lisasnt/HSD-RP2040-5-stepper-motor-driver/kicad-project/Huge-Stepper-Driver.kicad_pcb

## KiCad design kicad-project/Huge-Stepper-Driver.kicad_pcb (2022-05-21)

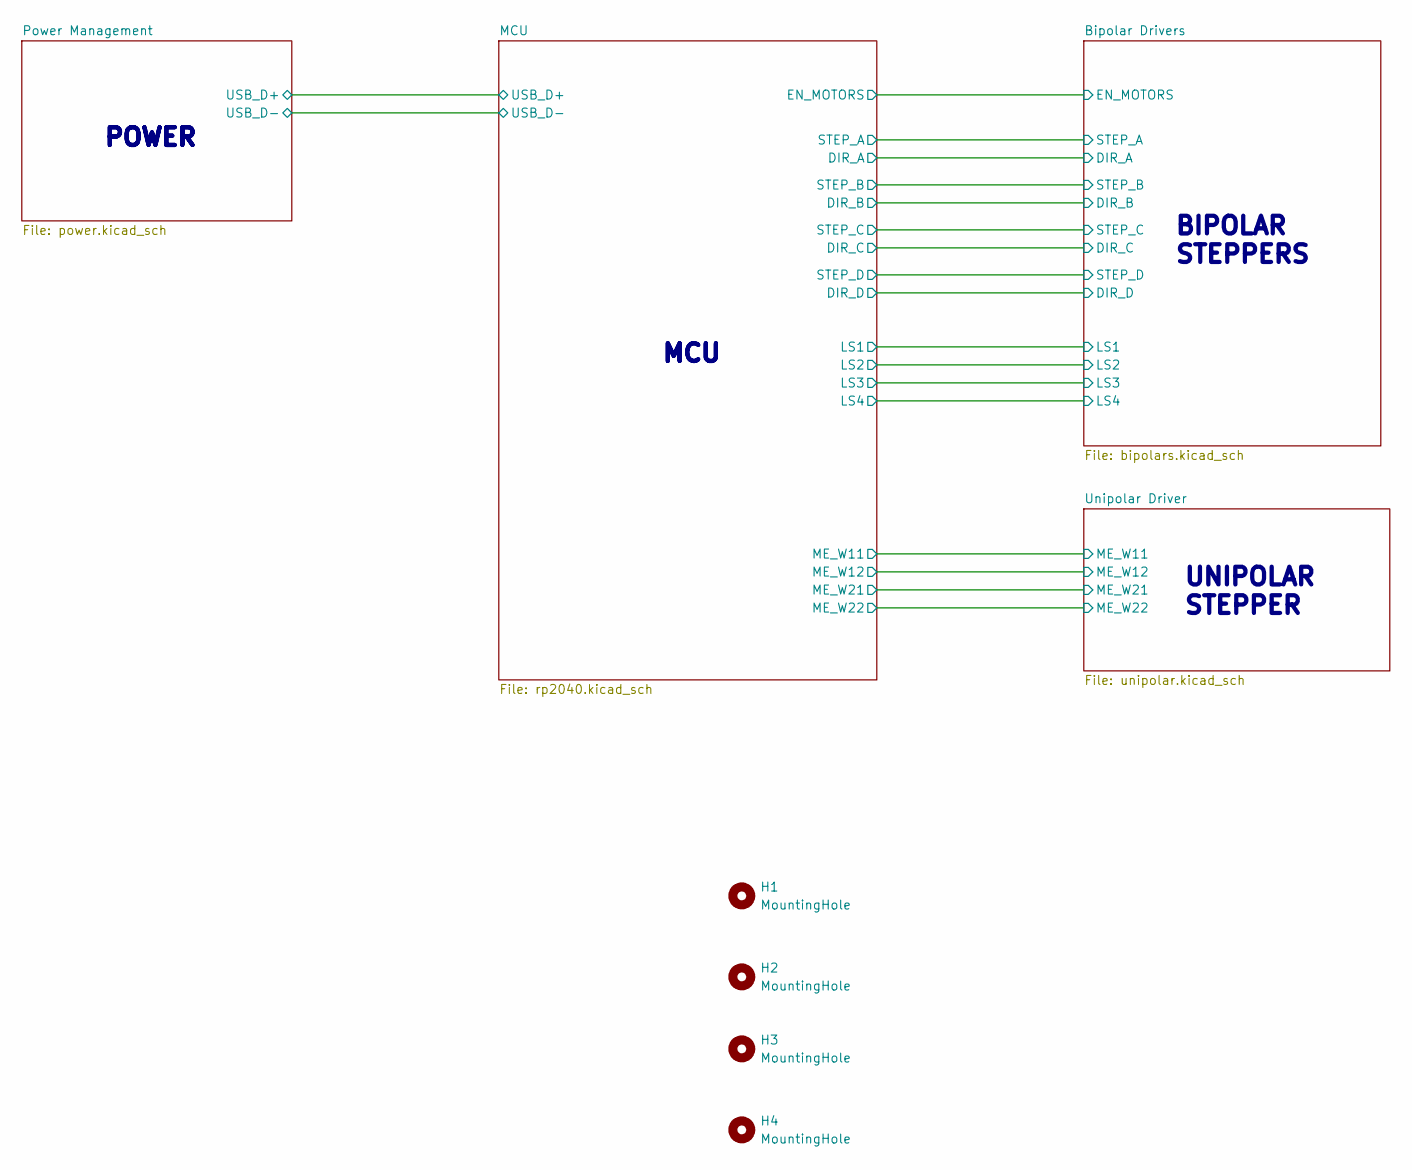
[picture p1: schematic Huge-Stepper-Driver.kicad_sch]

Parts:
H1, H2, H3, H4: MountingHole; MountingHole_3.2mm_M3

Notes on the sheet:
MCU
UNIPOLAR STEPPER
POWER
BIPOLAR STEPPERS

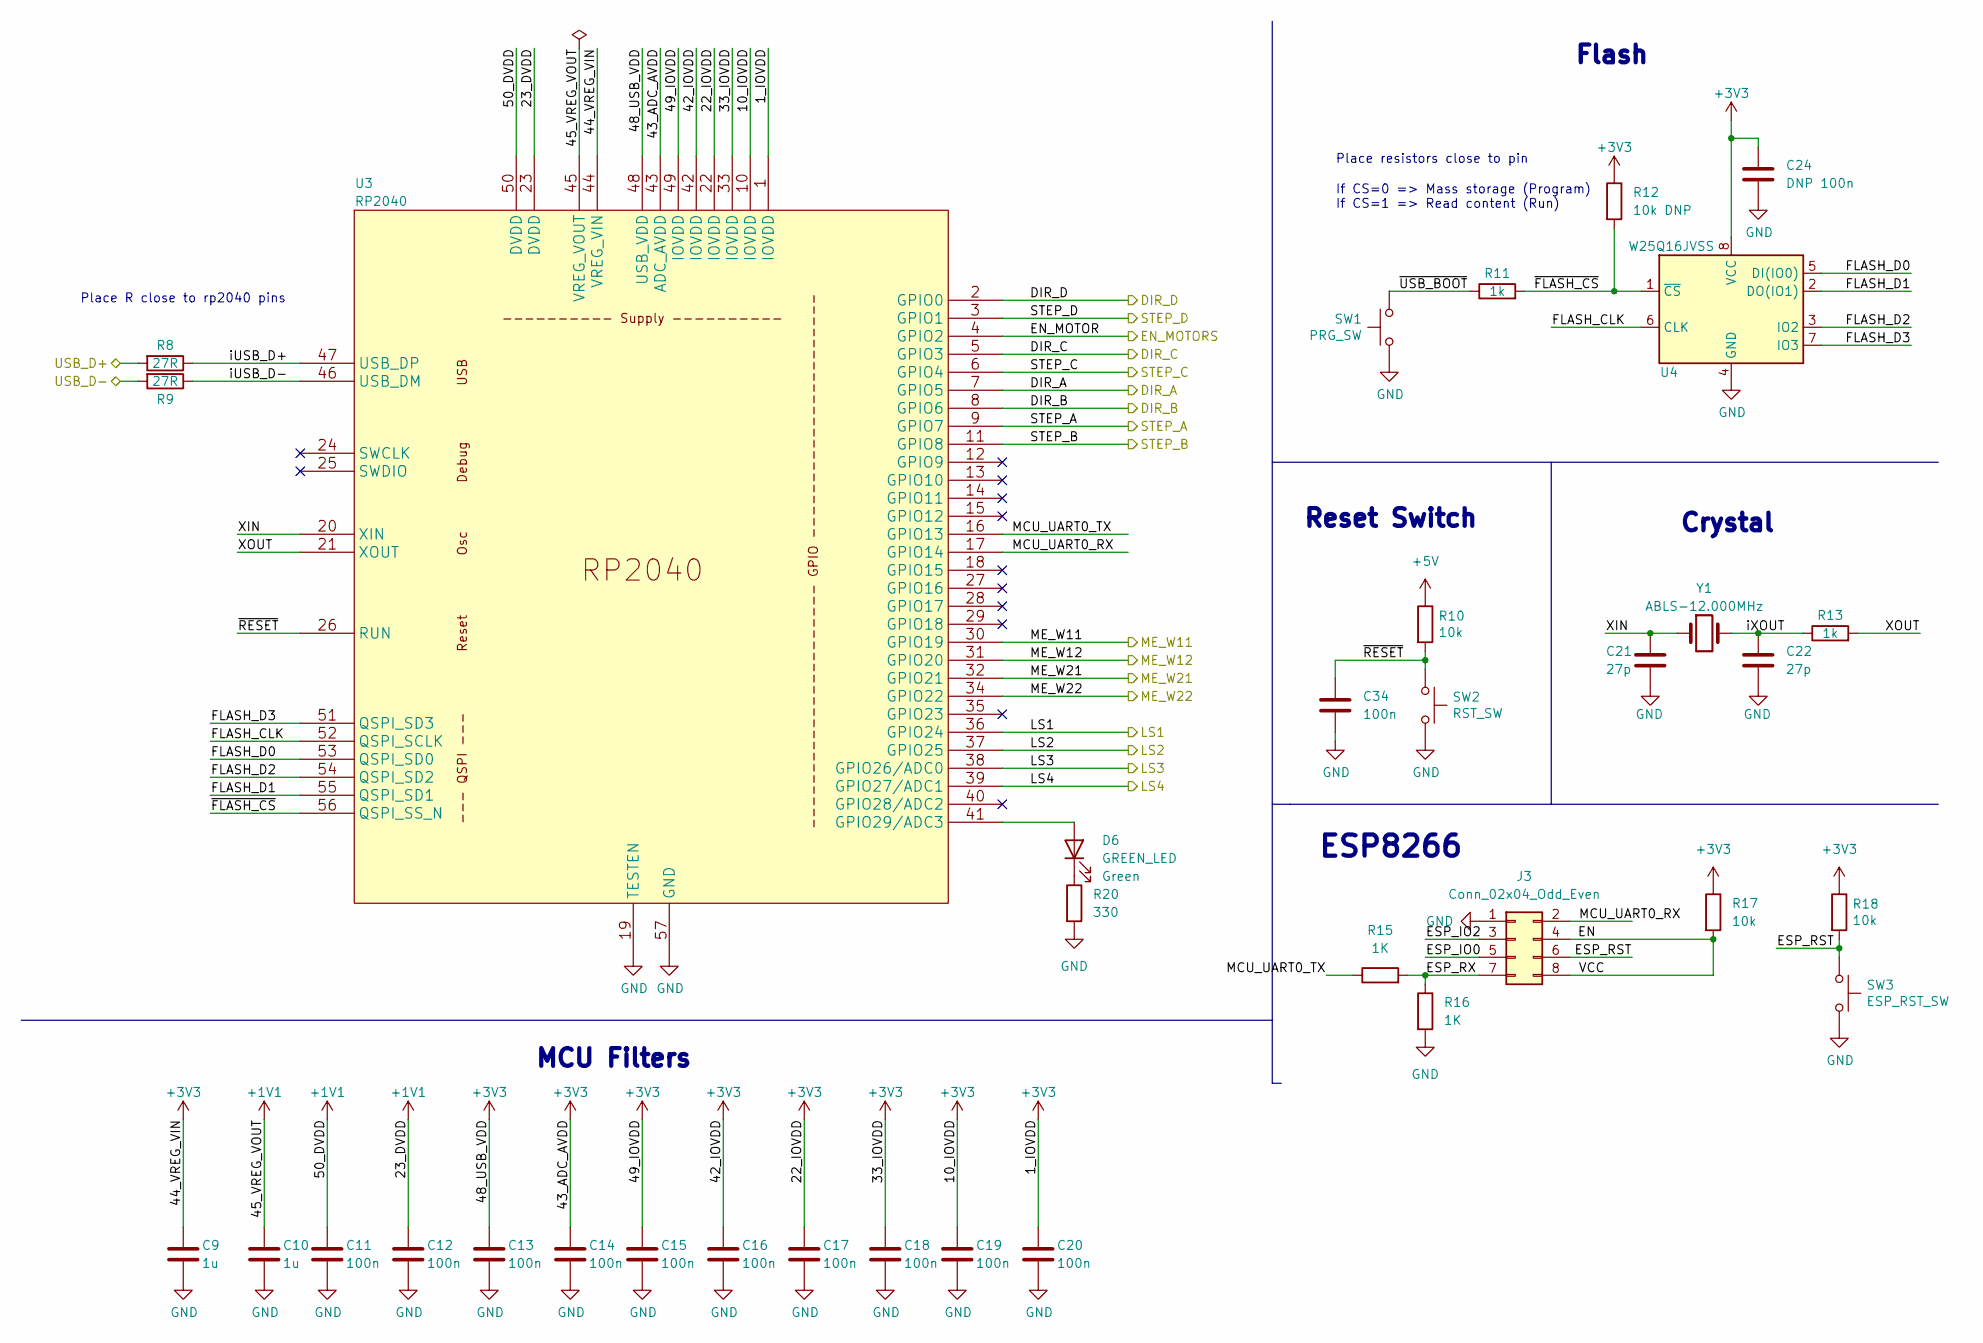
[picture p2: schematic rp2040.kicad_sch]

Parts:
C9, C10: 1u; C_0805_2012Metric
C11, C12, C13, C14, C15, C16, C17, C18, C19, C20, C34: 100n; C_0603_1608Metric
C21, C22: 27p; C_0603_1608Metric
C24: DNP 100n; C_0603_1608Metric
D6: GREEN_LED; LED_0603_1608Metric
J3: Conn_02x04_Odd_Even; PinHeader_2x04_P2.54mm_Vertical
R8, R9: 27R; R_0603_1608Metric
R10, R17, R18: 10k; R_0603_1608Metric
R11, R13: 1k; R_0603_1608Metric
R12: 10k DNP; R_0603_1608Metric
R15, R16: 1K; R_0603_1608Metric
R20: 330; R_0603_1608Metric
SW1: PRG_SW; SW_Push_1P1T_NO_CK_KMR2
SW2: RST_SW; SW_Push_1P1T_NO_CK_KMR2
SW3: ESP_RST_SW; SW_Push_1P1T_NO_CK_KMR2
U3: RP2040; RP2040-Hand-Solder
U4: W25Q16JVSS; SOIC-8_5.23x5.23mm_P1.27mm
Y1: ABLS-12.000MHz; Crystal_SMD_HC49-SD

Connections:
+1V1: C10.1, C11.1, C12.1, U3.23 (DVDD), U3.45 (VREG_VOUT), U3.50 (DVDD)
+5V: R10.1; also elsewhere on the board
/Bipolar Drivers/LS1: U3.36 (GPIO24); also elsewhere on the board
/Bipolar Drivers/LS2: U3.37 (GPIO25); also elsewhere on the board
/Bipolar Drivers/LS3: U3.38 (GPIO26/ADC0); also elsewhere on the board
/Bipolar Drivers/LS4: U3.39 (GPIO27/ADC1); also elsewhere on the board
/MCU/DIR_A: U3.7 (GPIO5); also elsewhere on the board
/MCU/DIR_B: U3.8 (GPIO6); also elsewhere on the board
/MCU/DIR_C: U3.5 (GPIO3); also elsewhere on the board
/MCU/DIR_D: U3.2 (GPIO0); also elsewhere on the board
/MCU/EN: J3.4, J3.8, R17.2
/MCU/EN_MOTOR: U3.4 (GPIO2); also elsewhere on the board
/MCU/ESP_IO0: J3.5
/MCU/ESP_IO2: J3.3
/MCU/ESP_RST: J3.6, R18.2, SW3.1
/MCU/ESP_RX: J3.7, R15.2, R16.1
/MCU/FLASH_CLK: U3.52 (QSPI_SCLK), U4.6 (CLK)
/MCU/FLASH_D0: U3.53 (QSPI_SD0), U4.5 (DI(IO0))
/MCU/FLASH_D1: U3.55 (QSPI_SD1), U4.2 (DO(IO1))
/MCU/FLASH_D2: U3.54 (QSPI_SD2), U4.3 (IO2)
/MCU/FLASH_D3: U3.51 (QSPI_SD3), U4.7 (IO3)
/MCU/MCU_UART0_RX: J3.2, U3.17 (GPIO14)
/MCU/MCU_UART0_TX: R15.1, U3.16 (GPIO13)
/MCU/ME_W11: U3.30 (GPIO19); also elsewhere on the board
/MCU/ME_W12: U3.31 (GPIO20); also elsewhere on the board
/MCU/ME_W21: U3.32 (GPIO21); also elsewhere on the board
/MCU/ME_W22: U3.34 (GPIO22); also elsewhere on the board
/MCU/STEP_A: U3.9 (GPIO7); also elsewhere on the board
/MCU/STEP_B: U3.11 (GPIO8); also elsewhere on the board
/MCU/STEP_C: U3.6 (GPIO4); also elsewhere on the board
/MCU/STEP_D: U3.3 (GPIO1); also elsewhere on the board
/MCU/USB_D+: R8.2; also elsewhere on the board
/MCU/USB_D-: R9.2; also elsewhere on the board
/MCU/XIN: C21.1, U3.20 (XIN), Y1.1
/MCU/XOUT: R13.2, U3.21 (XOUT)
/MCU/iUSB_D+: R8.1, U3.47 (USB_DP)
/MCU/iUSB_D-: R9.1, U3.46 (USB_DM)
/MCU/iXOUT: C22.1, R13.1, Y1.2
/MCU/~FLASH_CS: R11.2, R12.2, U3.56 (QSPI_SS_N), U4.1 (~CS)
/MCU/~RESET: C34.1, R10.2, SW2.1, U3.26 (RUN)
/MCU/~USB_BOOT: R11.1, SW1.1
GND: C9.2, C10.2, C11.2, C12.2, C13.2, C14.2, C15.2, C16.2, C17.2, C18.2, C19.2, C20.2, C21.2, C22.2, C24.2, C34.2, J3.1, R16.2, R20.2, SW1.2, SW2.2, SW3.2, U3.19 (TESTEN), U3.57 (GND), U4.4 (GND); also elsewhere on the board
unnamed: D6.1 (K), R20.1
unnamed: D6.2 (A), U3.41 (GPIO29/ADC3)

Notes on the sheet:
Reset Switch
Crystal
ESP8266
Flash
If CS=0 => Mass storage (Program) If CS=1 => Read content (Run)
Place resistors close to pin
MCU Filters
Place R close to rp2040 pins

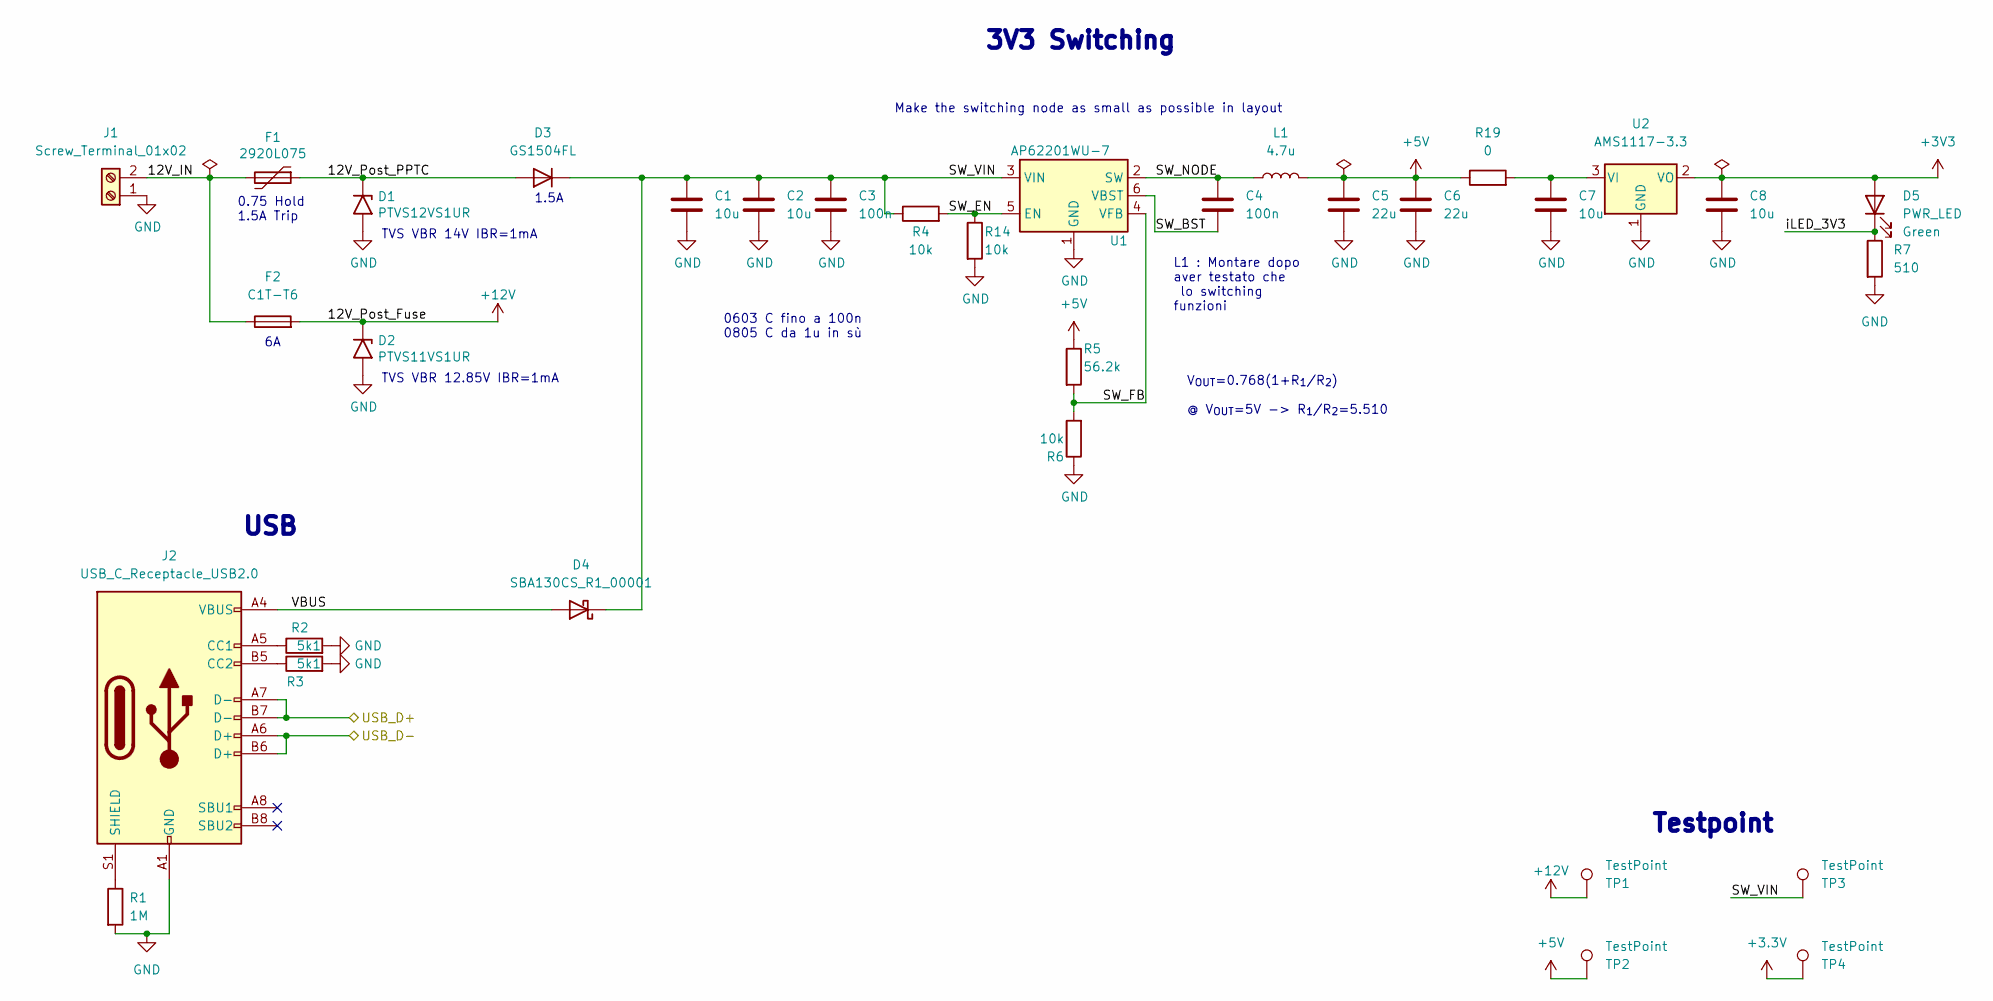
[picture p3: schematic power.kicad_sch]

Parts:
C1, C2, C7, C8: 10u; C_0805_2012Metric
C3, C4: 100n; C_0603_1608Metric
C5, C6: 22u; C_0805_2012Metric
D1: PTVS12VS1UR; D_SOD-123
D2: PTVS11VS1UR; D_SOD-123
D3: GS1504FL; D_SOD-123F
D4: SBA130CS_R1_00001; D_SOD-323
D5: PWR_LED; LED_0603_1608Metric
F1: 2920L075; Fuse_2920_7451Metric
F2: C1T-T6; Fuse_1206_3216Metric
J1: Screw_Terminal_01x02; TerminalBlock_RND_205-00001_1x02_P5.00mm_Horizontal
J2: USB_C_Receptacle_USB2.0; USB-C-USB4105-GF-A-120
L1: 4.7u; Inductance
R1: 1M; R_0603_1608Metric
R2, R3: 5k1; R_0603_1608Metric
R4, R6, R14: 10k; R_0603_1608Metric
R5: 56.2k; R_0603_1608Metric
R7: 510; R_0603_1608Metric
R19: 0; R_0603_1608Metric
TP1, TP2, TP3, TP4: TestPoint; TestPoint_Keystone_5005-5009_Compact
U1: AP62201WU-7; TSOT-23-6
U2: AMS1117-3.3; SOT-223-3_TabPin2

Connections:
+5V: C5.1, C6.1, L1.2, R5.1, R19.1, TP2.1; also elsewhere on the board
+12V: D2.1 (A1), F2.2, TP1.1; also elsewhere on the board
/MCU/USB_D+: J2.A7 (D-), J2.B7 (D-); also elsewhere on the board
/MCU/USB_D-: J2.A6 (D+), J2.B6 (D+); also elsewhere on the board
/Power Management/12V_IN: F1.2, F2.1, J1.2
/Power Management/12V_Post_PPTC: D1.1 (A1), D3.2 (A), F1.1
/Power Management/SW_BST: C4.2, U1.6 (VBST)
/Power Management/SW_EN: R4.2, R14.1, U1.5 (EN)
/Power Management/SW_FB: R5.2, R6.2, U1.4 (VFB)
/Power Management/SW_NODE: C4.1, L1.1, U1.2 (SW)
/Power Management/SW_VIN: C1.1, C2.1, C3.1, D3.1 (K), D4.1 (K), R4.1, TP3.1, U1.3 (VIN)
/Power Management/VBUS: D4.2 (A), J2.A4 (VBUS), J2.A9 (VBUS), J2.B4 (VBUS), J2.B9 (VBUS)
/Power Management/iLED_3V3: D5.1 (K), R7.1
GND: C1.2, C2.2, C3.2, C5.2, C6.2, C7.2, C8.2, D1.2 (A2), D2.2 (A2), J1.1, J2.A1 (GND), J2.A12 (GND), J2.B1 (GND), J2.B12 (GND), R1.2, R2.2, R3.2, R6.1, R7.2, R14.2, U1.1 (GND), U2.1 (GND); also elsewhere on the board
unnamed: C7.1, R19.2, U2.3 (VI)
unnamed: J2.A5 (CC1), R2.1
unnamed: J2.B5 (CC2), R3.1
unnamed: J2.S1 (SHIELD), R1.1

Notes on the sheet:
L1 : Montare dopo aver testato che lo switching funzioni
TVS VBR 14V IBR=1mA
Make the switching node as small as possible in layout
Testpoint
0603 C fino a 100n 0805 C da 1u in sù
1.5A
V_{OUT}=0.768(1+R_{1}/R_{2}) @ V_{OUT}=5V -> R_{1}/R_{2}=5.510
0.75 Hold 1.5A Trip
USB
TVS VBR 12.85V IBR=1mA
3V3 Switching

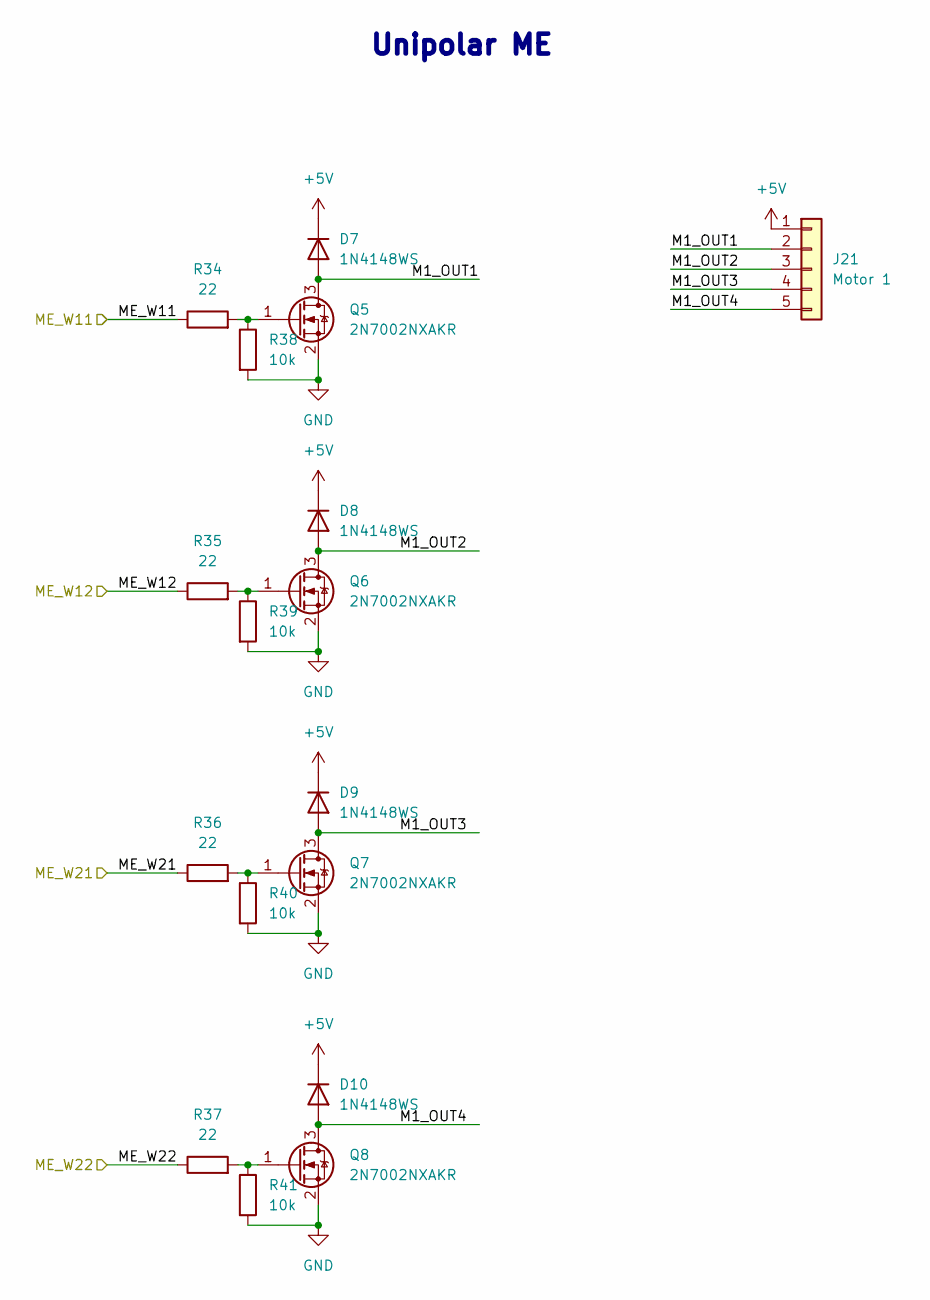
[picture p4: schematic unipolar.kicad_sch]

Parts:
D7, D8, D9, D10: 1N4148WS; D_SOD-323
J21: Motor 1; JST_XH_B5B-XH-AM_1x05_P2.50mm_Vertical
Q5, Q6, Q7, Q8: 2N7002NXAKR; SOT-23
R34, R35, R36, R37: 22; R_0603_1608Metric
R38, R39, R40, R41: 10k; R_0603_1608Metric

Connections:
+5V: D7.1 (K), D8.1 (K), D9.1 (K), D10.1 (K), J21.1; also elsewhere on the board
/MCU/ME_W11: R34.1; also elsewhere on the board
/MCU/ME_W12: R35.1; also elsewhere on the board
/MCU/ME_W21: R36.1; also elsewhere on the board
/MCU/ME_W22: R37.1; also elsewhere on the board
/Unipolar Driver /M1_OUT1: D7.2 (A), J21.2, Q5.3 (D)
/Unipolar Driver /M1_OUT2: D8.2 (A), J21.3, Q6.3 (D)
/Unipolar Driver /M1_OUT3: D9.2 (A), J21.4, Q7.3 (D)
/Unipolar Driver /M1_OUT4: D10.2 (A), J21.5, Q8.3 (D)
GND: Q5.2 (S), Q6.2 (S), Q7.2 (S), Q8.2 (S), R38.2, R39.2, R40.2, R41.2; also elsewhere on the board
unnamed: Q5.1 (G), R34.2, R38.1
unnamed: Q6.1 (G), R35.2, R39.1
unnamed: Q7.1 (G), R36.2, R40.1
unnamed: Q8.1 (G), R37.2, R41.1

Notes on the sheet:
Unipolar ME

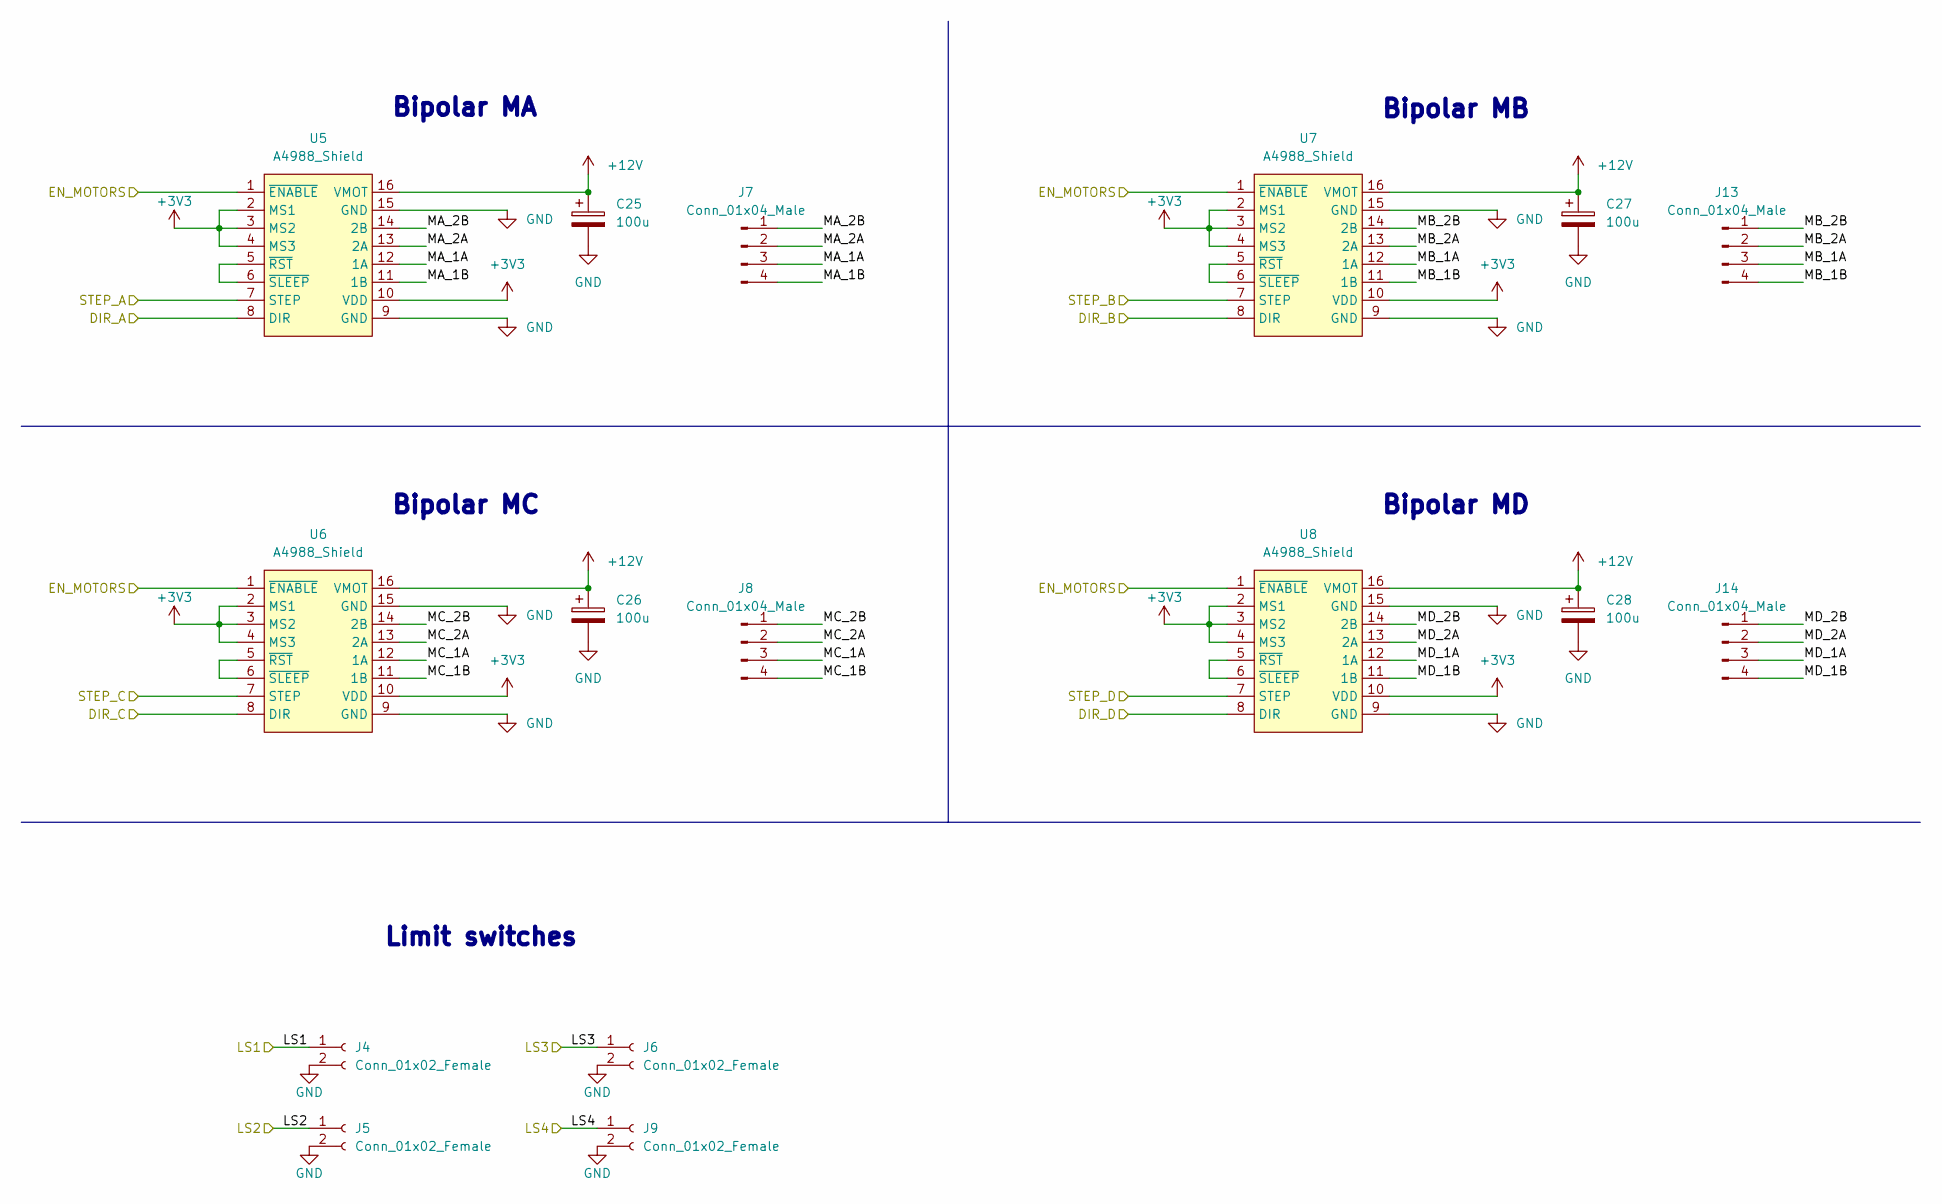
[picture p5: schematic bipolars.kicad_sch]

Parts:
C25, C26, C27, C28: 100u; CP_Elec_6.3x5.3
J4, J5, J6, J9: Conn_01x02_Female; PinHeader_1x02_P2.54mm_Vertical
J7, J8, J13, J14: Conn_01x04_Male; PinHeader_1x04_P2.54mm_Vertical
U5, U6, U7, U8: A4988_Shield

Connections:
+12V: C25.1, C26.1, C27.1, C28.1, U5.16 (VMOT), U6.16 (VMOT), U7.16 (VMOT), U8.16 (VMOT); also elsewhere on the board
/Bipolar Drivers/LS1: J4.1; also elsewhere on the board
/Bipolar Drivers/LS2: J5.1; also elsewhere on the board
/Bipolar Drivers/LS3: J6.1; also elsewhere on the board
/Bipolar Drivers/LS4: J9.1; also elsewhere on the board
/Bipolar Drivers/MA_1A: J7.3, U5.12 (1A)
/Bipolar Drivers/MA_1B: J7.4, U5.11 (1B)
/Bipolar Drivers/MA_2A: J7.2, U5.13 (2A)
/Bipolar Drivers/MA_2B: J7.1, U5.14 (2B)
/Bipolar Drivers/MB_1A: J13.3, U7.12 (1A)
/Bipolar Drivers/MB_1B: J13.4, U7.11 (1B)
/Bipolar Drivers/MB_2A: J13.2, U7.13 (2A)
/Bipolar Drivers/MB_2B: J13.1, U7.14 (2B)
/Bipolar Drivers/MC_1A: J8.3, U6.12 (1A)
/Bipolar Drivers/MC_1B: J8.4, U6.11 (1B)
/Bipolar Drivers/MC_2A: J8.2, U6.13 (2A)
/Bipolar Drivers/MC_2B: J8.1, U6.14 (2B)
/Bipolar Drivers/MD_1A: J14.3, U8.12 (1A)
/Bipolar Drivers/MD_1B: J14.4, U8.11 (1B)
/Bipolar Drivers/MD_2A: J14.2, U8.13 (2A)
/Bipolar Drivers/MD_2B: J14.1, U8.14 (2B)
/MCU/DIR_A: U5.8 (DIR); also elsewhere on the board
/MCU/DIR_B: U7.8 (DIR); also elsewhere on the board
/MCU/DIR_C: U6.8 (DIR); also elsewhere on the board
/MCU/DIR_D: U8.8 (DIR); also elsewhere on the board
/MCU/EN_MOTOR: U5.1 (~ENABLE), U6.1 (~ENABLE), U7.1 (~ENABLE), U8.1 (~ENABLE); also elsewhere on the board
/MCU/STEP_A: U5.7 (STEP); also elsewhere on the board
/MCU/STEP_B: U7.7 (STEP); also elsewhere on the board
/MCU/STEP_C: U6.7 (STEP); also elsewhere on the board
/MCU/STEP_D: U8.7 (STEP); also elsewhere on the board
GND: C25.2, C26.2, C27.2, C28.2, J4.2, J5.2, J6.2, J9.2, U5.9 (GND), U5.15 (GND), U6.9 (GND), U6.15 (GND), U7.9 (GND), U7.15 (GND), U8.9 (GND), U8.15 (GND); also elsewhere on the board
unnamed: U5.5 (~RST), U5.6 (~SLEEP)
unnamed: U6.5 (~RST), U6.6 (~SLEEP)
unnamed: U7.5 (~RST), U7.6 (~SLEEP)
unnamed: U8.5 (~RST), U8.6 (~SLEEP)

Notes on the sheet:
Bipolar MB
Bipolar MC
Limit switches
Bipolar MD
Bipolar MA

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
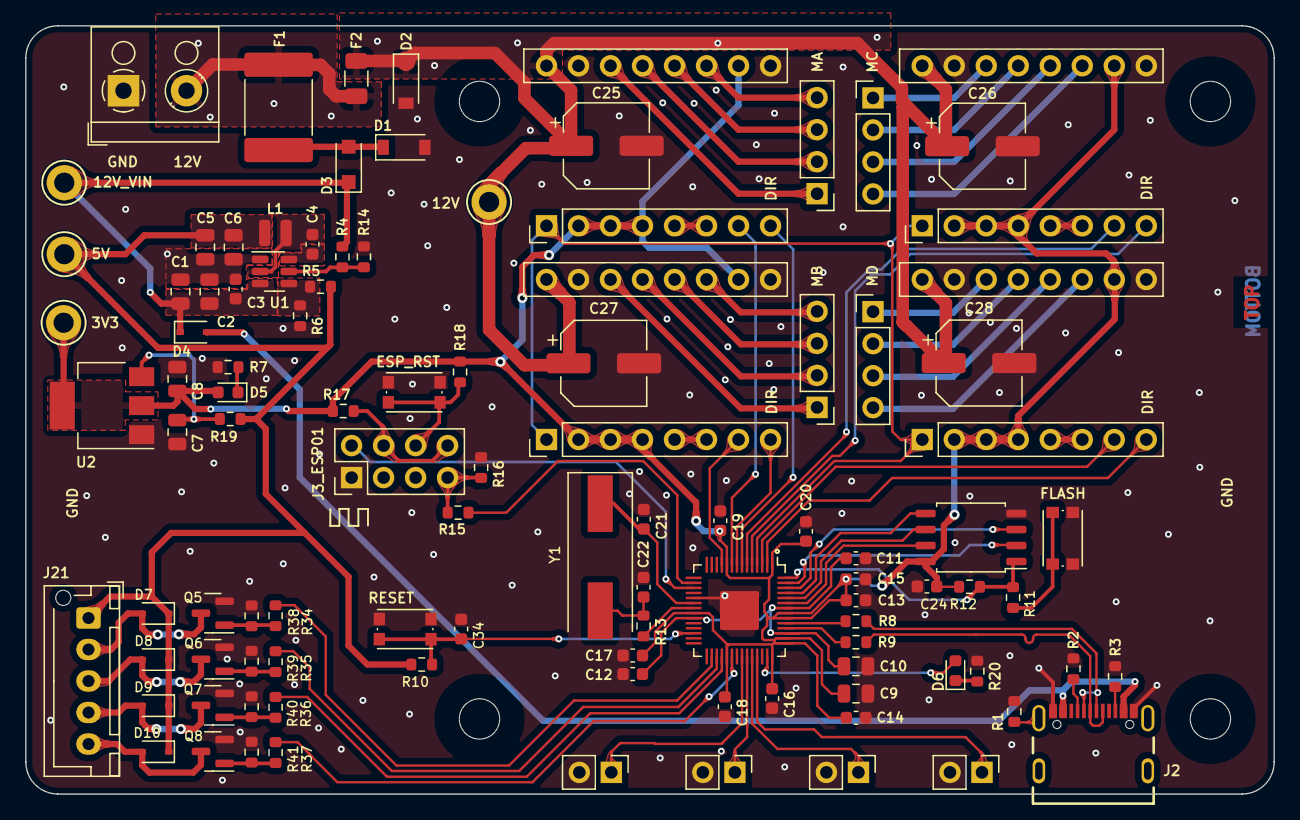
[picture p6: board Huge-Stepper-Driver.kicad_pcb from above]

Board: 2 copper layers, 99.1 x 61.0 mm, 105 parts (0 on the bottom side), 85 nets.
