lisasnt/HSD-RP2040-5-stepper-motor-driver/(commit log)

2022-04-04 update to step 8
    [5-stepper-driver.kicad_pcb, 5-stepper-driver.kicad_sch, atmega2560.kicad_sch, drivers.kicad_sch, power.kicad_sch]
2022-04-12 hw: rename poject and create project library
    [Huge-Stepper-Driver.kicad_pcb, Huge-Stepper-Driver.kicad_sch, drivers.kicad_sch, peripherals.kicad_sch, power.kicad_sch]
2022-04-12 hw: add power managment
    [Huge-Stepper-Driver.kicad_sch, drivers.kicad_sch, peripherals.kicad_sch, power.kicad_sch]
2022-04-21 hw: update
    [Huge-Stepper-Driver.kicad_sch, atmega2560.kicad_sch, drivers.kicad_sch, peripherals.kicad_sch, power.kicad_sch, unipolar.kicad_sch]
2022-05-01 hw: add esp8266
    [Huge-Stepper-Driver.kicad_sch, atmega2560.kicad_sch, drivers.kicad_sch, peripherals.kicad_sch, power.kicad_sch]
2022-05-01 hw: change to rp2040
    [Huge-Stepper-Driver.kicad_sch, atmega2560.kicad_sch, drivers.kicad_sch, peripherals.kicad_sch]
2022-05-01 hw: change power management and drivers
    [Huge-Stepper-Driver.kicad_sch, atmega2560.kicad_sch, drivers.kicad_sch, peripherals.kicad_sch, power.kicad_sch]
2022-05-04 Bipolar pins
    [Huge-Stepper-Driver.kicad_sch, atmega2560.kicad_sch, drivers.kicad_sch, peripherals.kicad_sch, power.kicad_sch]
2022-05-05 hw: update to complete schematic
    [Huge-Stepper-Driver.kicad_sch, bipolars.kicad_sch, drivers.kicad_sch, power.kicad_sch, rp2040.kicad_sch, unipolar.kicad_sch]
2022-05-07 hw: finish schematic
    [Huge-Stepper-Driver.kicad_sch, atmega2560.kicad_sch, bipolars.kicad_sch, drivers.kicad_sch, peripherals.kicad_sch, power.kicad_sch, rp2040.kicad_sch, unipolar.kicad_sch]
2022-05-10 hw: finish schematic, PS i2c R_pull-up wrong
    [Huge-Stepper-Driver.csv, Huge-Stepper-Driver.kicad_pcb, Huge-Stepper-Driver.kicad_sch, atmega2560.kicad_sch, bipolars.kicad_sch, drivers.kicad_sch, peripherals.kicad_sch, power.kicad_sch]
2022-05-10 hw: semplified schemtic, removed peripherals, fix merge
    [Huge-Stepper-Driver.kicad_sch, atmega2560.kicad_sch, bipolars.kicad_sch, drivers.kicad_sch, peripherals.kicad_sch, power.kicad_sch, rp2040.kicad_sch]
2022-05-11 hw: place layout component
    [Huge-Stepper-Driver.kicad_pcb, Huge-Stepper-Driver.kicad_sch, power.kicad_sch, rp2040.kicad_sch]
2022-05-12 prima versione pcb layout
    [Huge-Stepper-Driver.kicad_pcb]
2022-05-12 settings pcb cambiate
    [Huge-Stepper-Driver.kicad_pcb]
2022-05-13 fix unipolar e qualche rotta
    [Huge-Stepper-Driver.kicad_pcb, Huge-Stepper-Driver.kicad_sch, power.kicad_sch, unipolar.kicad_sch]
2022-05-16 hw: HSD v1.0 w/out peripherals
    [Huge-Stepper-Driver.kicad_pcb, Huge-Stepper-Driver.kicad_sch, bipolars.kicad_sch, power.kicad_sch, rp2040.kicad_sch, unipolar.kicad_sch]
2022-05-18 hw: updated HSD v1.0 + add gerber files
    [Huge-Stepper-Driver-B_Cu.gbr, Huge-Stepper-Driver-B_Mask.gbr, Huge-Stepper-Driver-B_Paste.gbr, Huge-Stepper-Driver-B_Silkscreen.gbr, Huge-Stepper-Driver-Edge_Cuts.gbr, Huge-Stepper-Driver-F_Cu.gbr, Huge-Stepper-Driver-F_Mask.gbr, Huge-Stepper-Driver-F_Paste.gbr]
2022-05-20 hw: update HSD v1.0
    [Huge-Stepper-Driver-B_Cu.gbr, Huge-Stepper-Driver-B_Mask.gbr, Huge-Stepper-Driver-B_Paste.gbr, Huge-Stepper-Driver-B_Silkscreen.gbr, Huge-Stepper-Driver-Edge_Cuts.gbr, Huge-Stepper-Driver-F_Cu.gbr, Huge-Stepper-Driver-F_Mask.gbr, Huge-Stepper-Driver-F_Paste.gbr]
2022-05-21 nuovi gerber e credits
    [Huge-Stepper-Driver-B_Cu.gbr, Huge-Stepper-Driver-B_Mask.gbr, Huge-Stepper-Driver-B_Paste.gbr, Huge-Stepper-Driver-B_Silkscreen.gbr, Huge-Stepper-Driver-Edge_Cuts.gbr, Huge-Stepper-Driver-F_Cu.gbr, Huge-Stepper-Driver-F_Mask.gbr, Huge-Stepper-Driver-F_Paste.gbr]
